Uspizig/smartknob/README.md

# smartknob
a BLDC Motor controller with the TMC6300 Driver and MT6701 magnetic encoder
