Uspizig/smartknob/smartknob/schematic.pdf

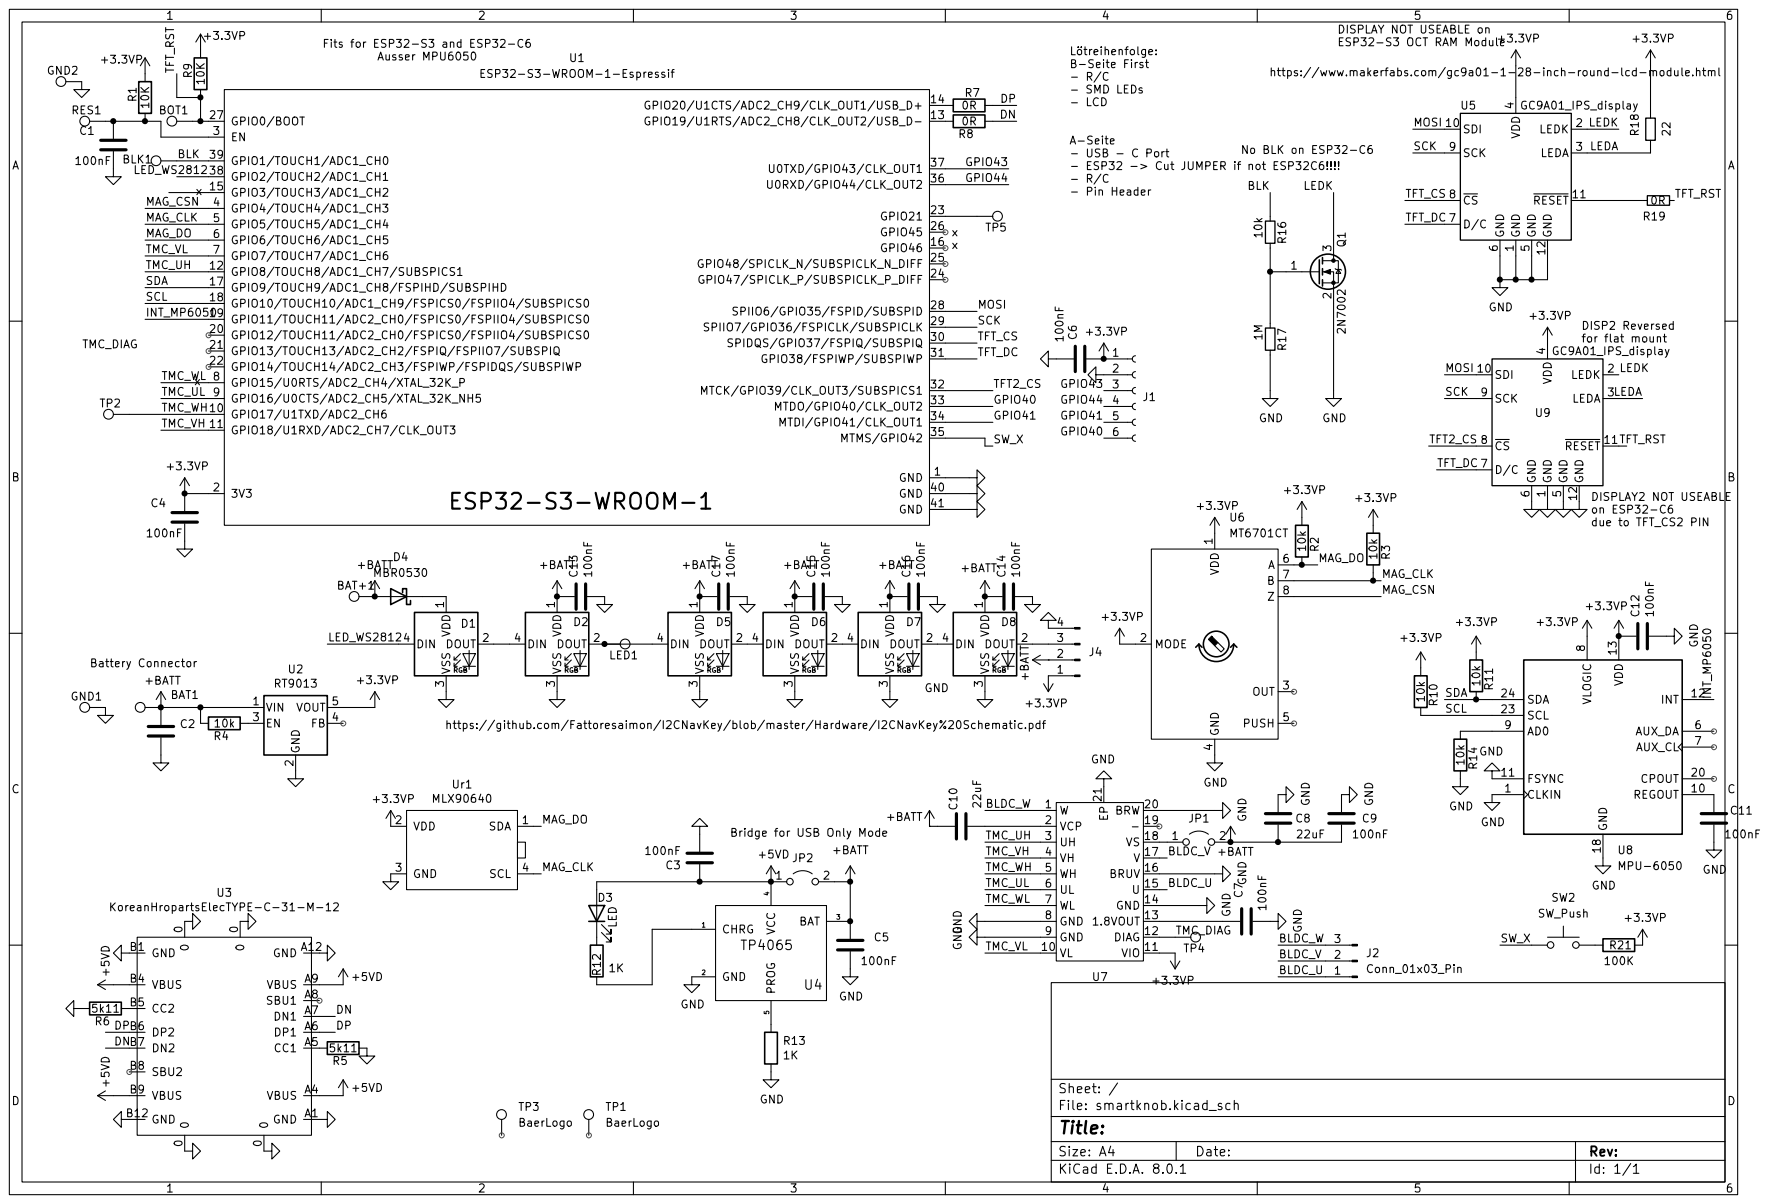
[picture p1: page 1]
