Uspizig/smartknob/smartknob/smartknob.kicad_pcb

## KiCad design smartknob/smartknob.kicad_pcb (2024-06-19)

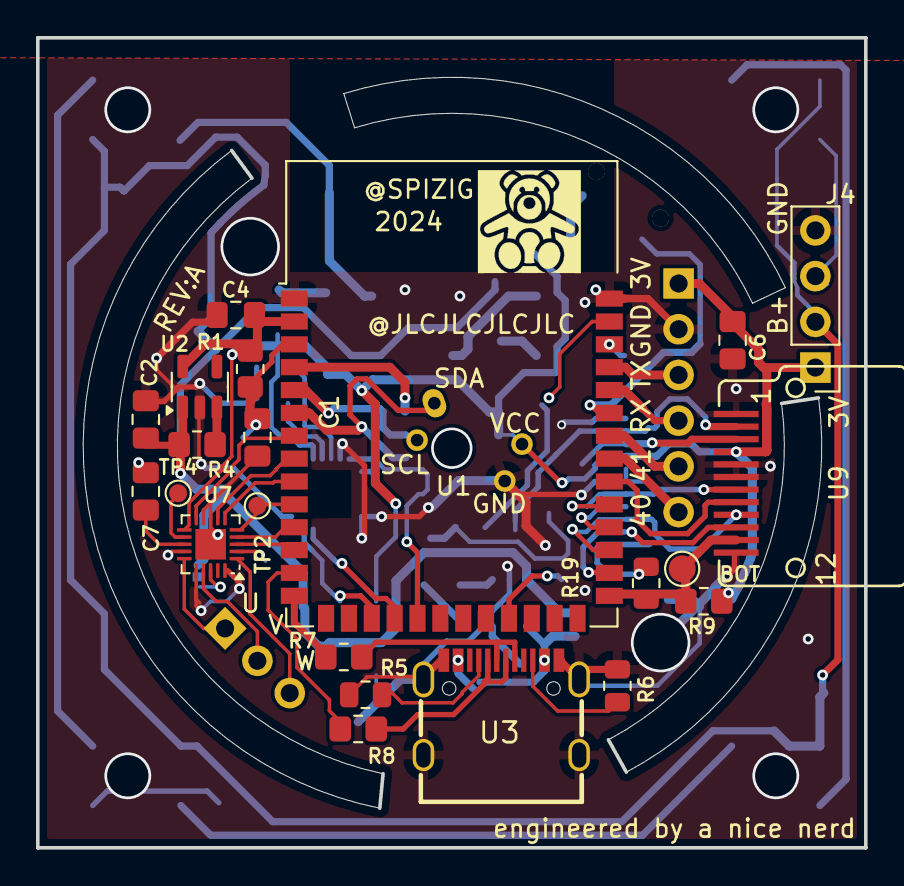
[picture p2: board smartknob.kicad_pcb from above]

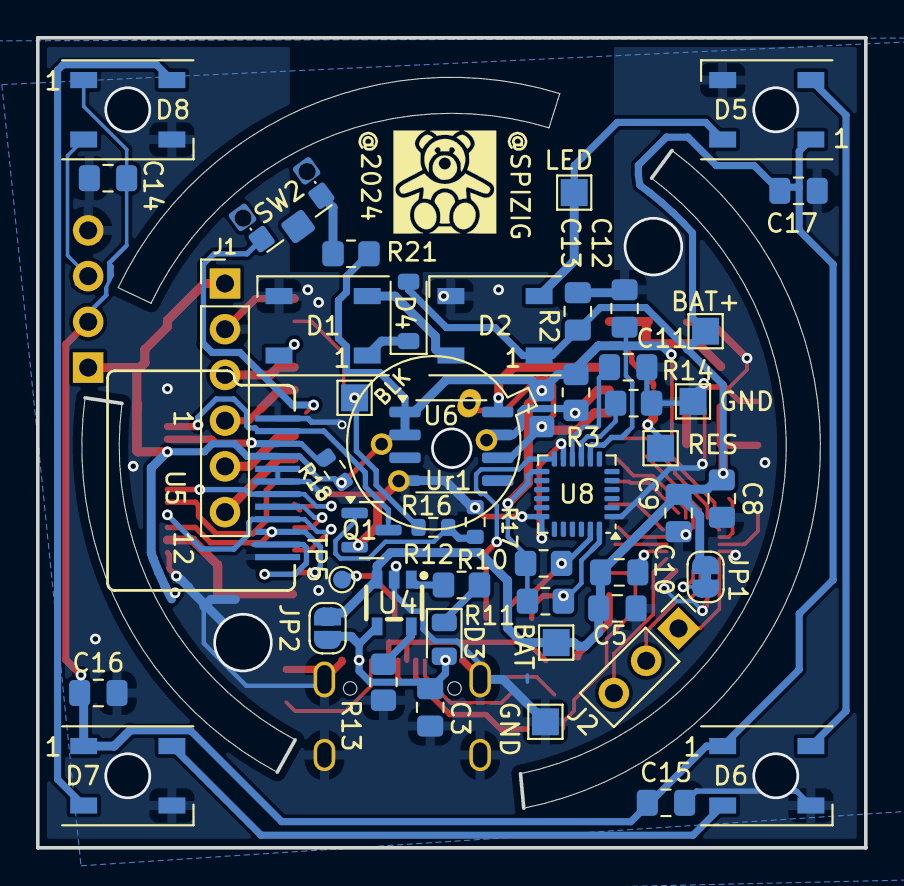
[picture p3: board smartknob.kicad_pcb from below]

Board: 2 copper layers, 46.0 x 45.0 mm, 74 parts (51 on the bottom side), 62 nets.

Parts:
BAT: TestPoint; TestPoint_Pad_1.5x1.5mm
BAT+: TestPoint; TestPoint_Pad_1.5x1.5mm
BLK: TestPoint; TestPoint_Pad_1.5x1.5mm
BOT: TestPoint; TestPoint_Pad_D1.5mm
C1, C3, C4, C5, C6, C7, C9, C11, C12, C13, C14, C15, C16, C17: 100nF; C_0805_2012Metric_Pad1.18x1.45mm_HandSolder
C2: 4.7uF50V; C_0805_2012Metric_Pad1.18x1.45mm_HandSolder
C8, C10: 22uF; C_0805_2012Metric_Pad1.18x1.45mm_HandSolder
D1, D2, D5, D6, D7, D8: WS2812B; LED_WS2812B_PLCC4_5.0x5.0mm_P3.2mm
D3: LED; LED_0805_2012Metric
D4: MBR0530; D_SOD-123
GND: TestPoint; TestPoint_Pad_1.5x1.5mm
GND#2: TestPoint; TestPoint_Pad_1.5x1.5mm
J1: Conn_01x06_Female; PinHeader_1x06_P2.54mm_Vertical
J2: Conn_01x03_Pin; PinHeader_1x03_P2.54mm_Vertical
J4: Conn_01x04_Pin; PinHeader_1x04_P2.54mm_Vertical
JP1: Jumper_2_Open; SolderJumper-2_P1.3mm_Bridged_RoundedPad1.0x1.5mm
JP2: Jumper_2_Open; SolderJumper-2_P1.3mm_Open_RoundedPad1.0x1.5mm
LED: TestPoint; TestPoint_Pad_1.5x1.5mm
Q1: 2N7002; SOT-23
R1, R9: 10K; R_0805_2012Metric_Pad1.20x1.40mm_HandSolder
R2, R3, R4, R10, R11, R14: 10k; R_0805_2012Metric_Pad1.20x1.40mm_HandSolder
R5, R6: 5k11; R_0805_2012Metric
R7, R8: 0R; R_0805_2012Metric_Pad1.20x1.40mm_HandSolder
R12, R13: 1K; R_0805_2012Metric_Pad1.20x1.40mm_HandSolder
R16: 10k; R_0603_1608Metric
R17: 1M; R_0603_1608Metric
R18: 22; R_0603_1608Metric
R19: 0R; R_0805_2012Metric
R21: 100K; R_0805_2012Metric_Pad1.20x1.40mm_HandSolder
RES: TestPoint; TestPoint_Pad_1.5x1.5mm
SW2: SW_Push; SW_SPST_CK_KMS2xxGP
TP1, TP3: BaerLogo; baerklein
TP2, TP4, TP5: TestPoint; TestPoint_Pad_D1.0mm
U1: ESP32-S3-WROOM-1-Espressif; ESP32-S3-WROOM-1
U2: RT9013; SOT-23-5
U3: KoreanHropartsElecTYPE-C-31-M-12; USB-C_SMD-TYPE-C-31-M-12
U4: TP4065; SOT-23-5_L3.0-W1.7-P0.95-LS2.8-BR
U5: GC9A01_IPS_display
U6: MT6701CT; SO-8_3.9x4.9mm_P1.27mm
U7: WQFN-20-1EP_3x3mm_P0.4mm_EP1.7x1.7mm
U8: MPU-6050; InvenSense_QFN-24_4x4mm_P0.5mm
U9: GC9A01_IPS_display; GC9A01_IPS_display_reversed
Ur1: MLX90640

Connections:
+3.3VP: C4.2, C6.2, C12.1, J1.1, J4.1, R1.2, R2.1, R3.1, R9.2, R10.1, R11.1, R18.1, R21.1, U1.2 (3V3), U2.5 (VOUT), U5.4 (VDD), U6.1 (VDD), U6.2 (MODE), U7.11 (VIO), U8.8 (VLOGIC), U8.13 (VDD), U9.4 (VDD), Ur1.2 (VDD)
+5VD: C3.1, D3.2 (A), JP2.1 (A), U3.A4 (VBUS), U3.A9 (VBUS), U3.B4 (VBUS), U3.B9 (VBUS), U4.4 (VCC)
+BATT: BAT.1, BAT+.1, C2.2, C5.2, C8.1, C9.1, C10.2, C13.1, C14.1, C15.1, C16.1, C17.1, D2.1 (VDD), D4.2 (A), D5.1 (VDD), D6.1 (VDD), D7.1 (VDD), D8.1 (VDD), J4.2, JP1.2 (B), JP2.2 (B), R4.2, U2.1 (VIN), U4.3 (BAT)
/BLDC_U: J2.1, U7.15 (U)
/BLDC_V: J2.2, U7.17 (V)
/BLDC_W: J2.3, U7.1 (W)
/BLK: BLK.1, R16.2, U1.39 (GPIO1/TOUCH1/ADC1_CH0)
/DN: R8.1, U3.A7 (DN1), U3.B7 (DN2)
/DP: R7.2, U3.A6 (DP1), U3.B6 (DP2)
/GPIO40: J1.6, U1.33 (MTDO/GPIO40/CLK_OUT2)
/GPIO41: J1.5, U1.34 (MTDI/GPIO41/CLK_OUT1)
/GPIO43: J1.3, U1.37 (U0TXD/GPIO43/CLK_OUT1)
/GPIO44: J1.4, U1.36 (U0RXD/GPIO44/CLK_OUT2)
/INT_MP6050: U1.19 (GPIO11/TOUCH11/ADC2_CH0/FSPICS0/FSPIIO4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), U8.12 (INT)
/LEDA: R18.2, U5.3 (LEDA), U9.3 (LEDA)
/LEDK: Q1.3 (D), U5.2 (LEDK), U9.2 (LEDK)
/LED_WS2812: D1.4 (DIN), U1.38 (GPIO2/TOUCH2/ADC1_CH1)
/MAG_CLK: R3.2, U1.5 (GPIO5/TOUCH5/ADC1_CH4), U6.7 (B), Ur1.4 (SCL)
/MAG_CSN: U1.4 (GPIO4/TOUCH4/ADC1_CH3), U6.8 (Z)
/MAG_DO: R2.2, U1.6 (GPIO6/TOUCH6/ADC1_CH5), U6.6 (A), Ur1.1 (SDA)
/MOSI: U1.28 (SPIIO6/GPIO35/FSPID/SUBSPID), U5.10 (SDI), U9.10 (SDI)
/SCK: U1.29 (SPIIO7/GPIO36/FSPICLK/SUBSPICLK), U5.9 (SCK), U9.9 (SCK)
/SCL: R10.2, U1.18 (GPIO10/TOUCH10/ADC1_CH9/FSPICS0/FSPIIO4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), U8.23 (SCL)
/SDA: R11.2, U1.17 (GPIO9/TOUCH9/ADC1_CH8/FSPIHD/SUBSPIHD), U8.24 (SDA)
/SW_X: SW2.2, U1.35 (MTMS/GPIO42)
/TFT2_CS: U1.32 (MTCK/GPIO39/CLK_OUT3/SUBSPICS1), U9.8 (~CS)
/TFT_CS: U1.30 (SPIDQS/GPIO37/FSPIQ/SUBSPIQ), U5.8 (~CS)
/TFT_DC: U1.31 (GPIO38/FSPIWP/SUBSPIWP), U5.7 (D/C), U9.7 (D/C)
/TFT_RST: BOT.1, R9.1, R19.2, U1.27 (GPIO0/BOOT), U9.11 (~RESET)
/TMC_DIAG: TP4.1, U7.12 (DIAG)
/TMC_UH: U1.12 (GPIO8/TOUCH8/ADC1_CH7/SUBSPICS1), U7.3 (UH)
/TMC_UL: U1.9 (GPIO16/U0CTS/ADC2_CH5/XTAL_32K_NH5), U7.6 (UL)
/TMC_VH: U1.11 (GPIO18/U1RXD/ADC2_CH7/CLK_OUT3), U7.4 (VH)
/TMC_VL: U1.7 (GPIO7/TOUCH7/ADC1_CH6), U7.10 (VL)
/TMC_WH: TP2.1, U1.10 (GPIO17/U1TXD/ADC2_CH6), U7.5 (WH)
/TMC_WL: U1.8 (GPIO15/U0RTS/ADC2_CH4/XTAL_32K_P), U7.7 (WL)
GND: C1.1, C2.1, C3.2, C4.1, C5.1, C6.1, C7.1, C8.2, C9.2, C11.1, C12.2, C13.2, C14.2, C15.2, C16.2, C17.2, D1.3 (VSS), D2.3 (VSS), D5.3 (VSS), D6.3 (VSS), D7.3 (VSS), D8.3 (VSS), GND.1, GND#2.1, J1.2, J4.4, Q1.2 (S), R5.1, R6.2, R13.2, R14.2, R17.1, U1.1 (GND), U1.40 (GND), U2.2 (GND), U3.0, U3.A1 (GND), U3.A12 (GND), U3.B1 (GND), U3.B12 (GND), U4.2 (GND), U5.1 (GND), U5.5 (GND), U5.6 (GND), U5.12 (GND), U6.4 (GND), U7.8 (GND), U7.9 (GND), U7.14 (GND), U7.16 (BRUV), U7.20 (BRW), U7.21 (EP), U8.1 (CLKIN), U8.11 (FSYNC), U8.18 (GND), U9.1 (GND), U9.5 (GND), U9.6 (GND), U9.12 (GND), Ur1.3 (GND)
unnamed: D1.2 (DOUT), D2.4 (DIN)
unnamed: D1.1 (VDD), D4.1 (K)
unnamed: D2.2 (DOUT), D5.4 (DIN), LED.1
unnamed: D3.1 (K), R12.1
unnamed: D5.2 (DOUT), D6.4 (DIN)
unnamed: D6.2 (DOUT), D7.4 (DIN)
unnamed: D7.2 (DOUT), D8.4 (DIN)
unnamed: D8.2 (DOUT), J4.3
unnamed: JP1.1 (A), U7.18 (VS)
unnamed: Q1.1 (G), R16.1, R17.2
unnamed: R21.2, SW2.1
unnamed: C1.2, R1.1, RES.1, U1.3 (EN)
unnamed: R8.2, U1.13 (GPIO19/U1RTS/ADC2_CH8/CLK_OUT2/USB_D-)
unnamed: R7.1, U1.14 (GPIO20/U1CTS/ADC2_CH9/CLK_OUT1/USB_D+)
unnamed: TP5.1, U1.23 (GPIO21)
unnamed: R4.1, U2.3 (EN)
unnamed: R5.2, U3.A5 (CC1)
unnamed: R6.1, U3.B5 (CC2)
unnamed: R12.2, U4.1 (CHRG)
unnamed: R13.1, U4.5 (PROG)
unnamed: R19.1, U5.11 (~RESET)
unnamed: C7.2, U7.13 (1.8VOUT)
unnamed: C10.1, U7.2 (VCP)
unnamed: R14.1, U8.9 (AD0)
unnamed: C11.2, U8.10 (REGOUT)
