Uspizig/smartknob/Software/GC9A01_demo/GC9A01_demo.ino

#include <SPI.h>
#include "USB.h"
#include "GC9A01.h"

//Schreibtischlampe
/*#define RES 18
#define DC  17
#define CS  4
#define SCK  22
#define MISO  32
#define MOSI  21
#define SS  33
*/

#define RES 0
#define DC  38
#define CS  39
#define SCK  36
#define MISO  47
#define MOSI  35
#define SS  39
#define BLK 1


USBCDC USBSerial;

void GC9A01_set_reset(uint8_t val) {
    digitalWrite(RES, val);
}

void GC9A01_set_data_command(uint8_t val) {
    digitalWrite(DC, val);
}

void GC9A01_set_chip_select(uint8_t val) {
    digitalWrite(CS, val);
}

void GC9A01_spi_tx(uint8_t *data, size_t len) {
    while (len--) {
        SPI.transfer(*data);
        data++;
    }
}

void GC9A01_delay(uint16_t ms) {
    delay(ms);
}

void setup() {
    
    delay(1000);
    USBSerial.begin();USB.begin();
    delay(1000);
    pinMode(BLK, OUTPUT);
    pinMode(RES, OUTPUT);
    pinMode(DC, OUTPUT);
    pinMode(CS, OUTPUT);
    USBSerial.println("Pin Mode Set");
    //SPI.begin(22, 21);
    digitalWrite(BLK, 1);
    USBSerial.println("Pin Set BLK");
    SPI.begin(SCK, MISO, MOSI, SS);
    USBSerial.println("SPI Begin erledigt");
    USBSerial.println("Booting");
    GC9A01_init();
    struct GC9A01_frame frame = {{0,0},{239,239}};
    GC9A01_set_frame(frame);
    
}

void loop() {

    uint8_t color[3];

    // Triangle
    color[0] = 0xFF;
    color[1] = 0xFF;
    for (int x = 0; x < 240; x++) {
        for (int y = 0; y < 240; y++) {
            if (x < y) {
                color[2] = 0xFF;
            } else {
                color[2] = 0x00;
            }
            if (x == 0 && y == 0) {
                GC9A01_write(color, sizeof(color));
            } else {
                GC9A01_write_continue(color, sizeof(color));
            }
        }
    }

    delay(1000);

    // Rainbow
    USBSerial.println("Regenbogen erledigt");
    float frequency = 0.026;
    for (int x = 0; x < 240; x++) {
        color[0] = sin(frequency*x + 0) * 127 + 128;
        color[1] = sin(frequency*x + 2) * 127 + 128;
        color[2] = sin(frequency*x + 4) * 127 + 128;
        for (int y = 0; y < 240; y++) {
            if (x == 0 && y == 0) {
                GC9A01_write(color, sizeof(color));
            } else {
                GC9A01_write_continue(color, sizeof(color));
            }
        }
    }

    delay(1000);

    // Checkerboard
    USBSerial.println("Schachbrett");
    for (int x = 0; x < 240; x++) {
        for (int y = 0; y < 240; y++) {
            if ((x / 10) % 2 ==  (y / 10) % 2) {
                color[0] = 0xFF;
                color[1] = 0xFF;
                color[2] = 0xFF;
            } else {
                color[0] = 0x00;
                color[1] = 0x00;
                color[2] = 0x00;
            }
            if (x == 0 && y == 0) {
                GC9A01_write(color, sizeof(color));
            } else {
                GC9A01_write_continue(color, sizeof(color));
            }
        }
    }

    delay(1000);

    // Swiss flag
    USBSerial.println("Swiss flag");
    color[0] = 0xFF;
    for (int x = 0; x < 240; x++) {
        for (int y = 0; y < 240; y++) {
            if ((x >= 1*48 && x < 4*48 && y >= 2*48 && y < 3*48) ||
                (x >= 2*48 && x < 3*48 && y >= 1*48 && y < 4*48)) {
                color[1] = 0xFF;
                color[2] = 0xFF;
            } else {
                color[1] = 0x00;
                color[2] = 0x00;
            }
            if (x == 0 && y == 0) {
                GC9A01_write(color, sizeof(color));
            } else {
                GC9A01_write_continue(color, sizeof(color));
            }
        }
    }

    delay(1000);

}
